almost-online/scad_powerbank/boards/images/UFCS_PD45W.png

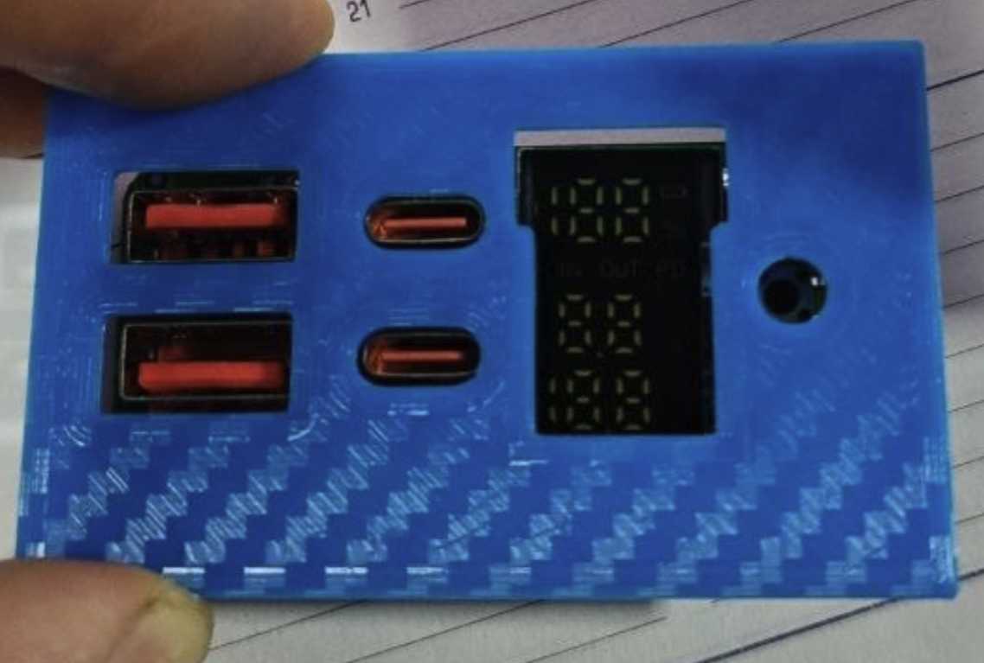
boards/images/UFCS_PD45W.png
