almost-online/scad_powerbank/(commit log)

2026-11-01 feat: initial powerbank enclosure generator with board sketcher backend
    - Parametric OpenSCAD powerbank case (powerbank_case.scad) with:
    - Front-to-back stacking: board pocket, partition, battery block
    - Modular snap-fit lid with ventilation lattice and snap-fit ridges
    - Removable front panel and partition in U-grooves
    - Built-in PCB side holders with textolite slot (1.2x4mm)
    - Support for 18650 cylindrical and pouch/prismatic batteries
    - Board preset system (boards/*.json -> generated_board_presets.scad):
    - JSON profiles with ports, displays, buttons, indicators
    - Polygon cutouts with parametric offset(delta=clearance)
    - Coordinate system: X horizontal, Y vertical (front fa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
    [powerbank_case.scad, presets_batteries.scad, presets_boards.scad]
2026-11-01 chore: translate all Ukrainian text to English
    - AGENT.md, AGENTS.md: full documentation translated
    - README.md: project documentation, parameters table, and guides translated
    - powerbank_case.scad: all comments translated
    - presets_batteries.scad, presets_boards.scad: header comments translated
    - tools/board_sketcher.html: all UI labels, buttons, status messages, and JavaScript strings translated
    [powerbank_case.scad, presets_batteries.scad, presets_boards.scad]
2026-11-01 refactor: replace board holders with horizontal side wall slots
    - Replace board_holder module with horizontal slots cut into left/right
    case walls along Z axis, at 6mm from front wall
    - New parameters: board_thickness (1.1mm), board_holder_slot_depth (1.5mm),
    board_holder_slot_offset (6.0mm)
    - Slot width auto-calculated as board_thickness + tolerance for free PCB fit
    - Slots are subtracted via difference() in powerbank_body(), forming a
    monolithic structure without extra parts
    - Updated AGENTS.md and README.md documentation
    [powerbank_case.scad, presets_batteries.scad, presets_boards.scad]
2026-11-01 refactor: board holders with vertical Z-axis slot for parallel assembly
    - Restore board_holder module as two side blocks with vertical slot
    along Z axis, positioned 6mm from front wall
    - Board slides in along Z together with front panel and partition
    - Parameters: board_thickness (1.1mm), board_holder_thick (1.2mm),
    board_holder_width (4.0mm), board_holder_slot_depth (1.5mm),
    - Slot width = board_thickness + tolerance for free PCB fit
    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
    [powerbank_case.scad]
2026-11-02 fix mainboard holder
    [powerbank_case.scad]
2026-11-02 chore: translate all Ukrainian text to English
    (cherry picked from commit 2b9bf0bcdc6a636804a0178965f2030f4be0686f)
    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
    [powerbank_case.scad, presets_batteries.scad, presets_boards.scad]
2026-11-02 chore: translate all comments in `powerbank_case.scad` from Ukrainian to English
    - Updated comments for clarity and consistency.
    - Ensure technical accuracy in translation.
    [powerbank_case.scad]
